haeun2525/nu40-color-picker/case/out/lid.stl

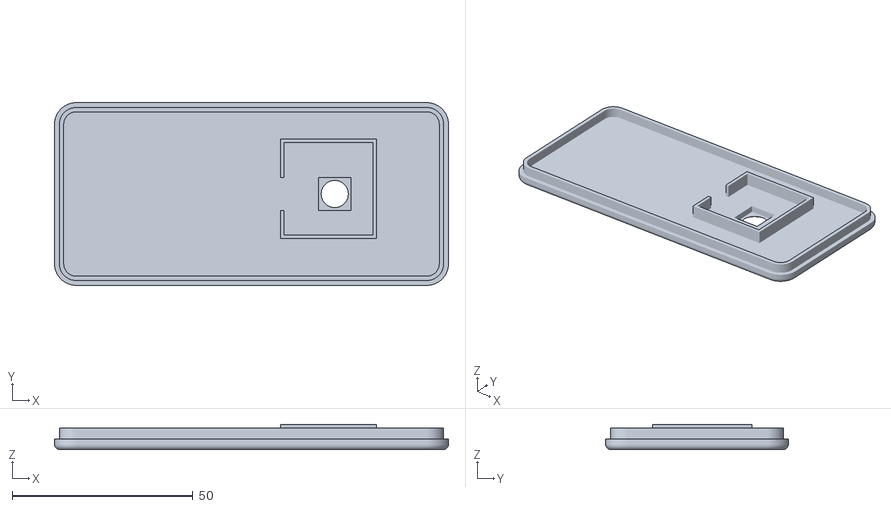
[picture p2: CAD file, 2026-10-26]
case/out/lid.stl
109.1 x 50.6 x 7.00
