haeun2525/nu40-color-picker/case/out/tub.stl

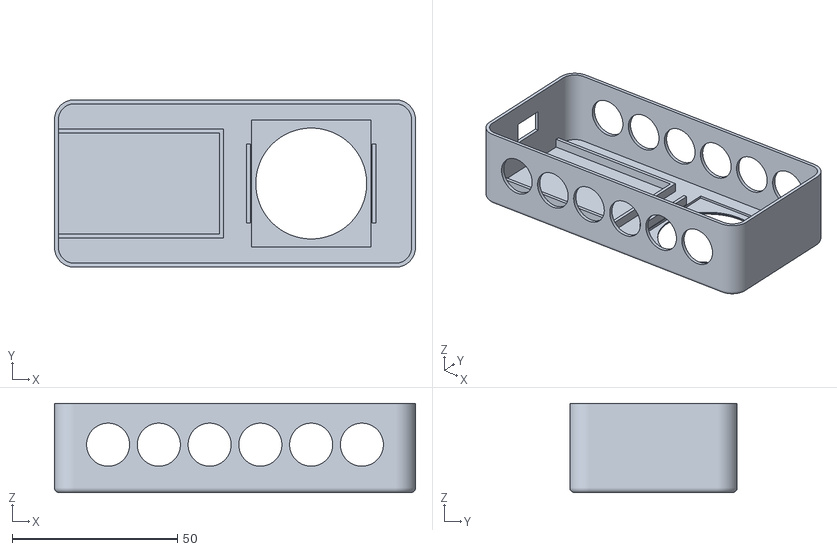
[picture p3: CAD file, 2026-10-26]
case/out/tub.stl
109.1 x 50.6 x 27.0
