haeun2525/nu40-color-picker/case/out/fit_gauge.stl

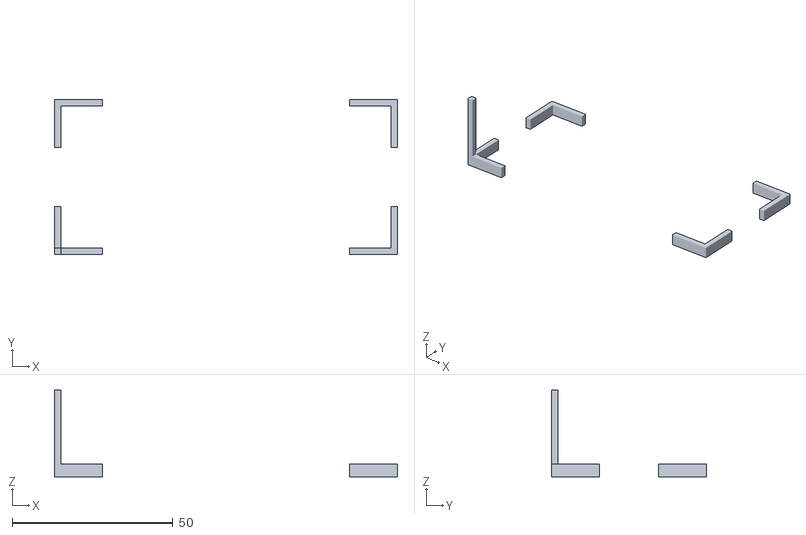
[picture p4: CAD file, 2026-10-26]
case/out/fit_gauge.stl
106.7 x 48.2 x 27.0
