haeun2525/nu40-color-picker/(commit log)

2026-10-26 카메라로 겨눈 곳의 색을 읽어 원형 화면에 띄우는 컬러 피커 — NU40 DK + Grove Vision AI V2 + GC9A01
    [fit_gauge.stl, lid.stl, tub.stl]
2026-10-26 Print serial messages in English
